awkyu/variable-force-servo-controller/Kyu_Alexander_Project_Report.pdf

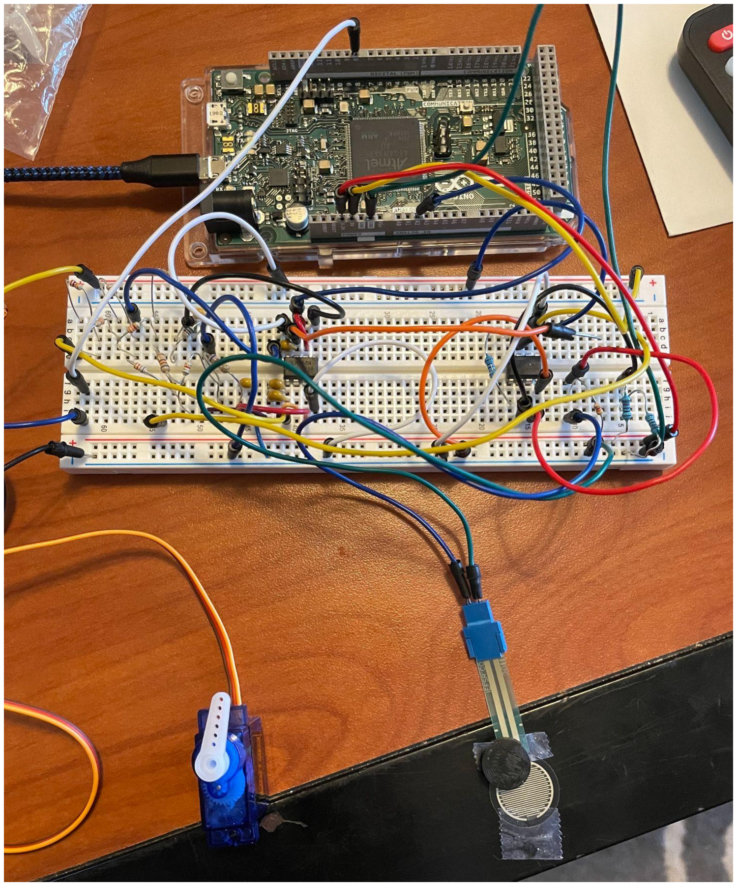
[picture p12: figure]
