awkyu/variable-force-servo-controller/IMG_8414.jpg

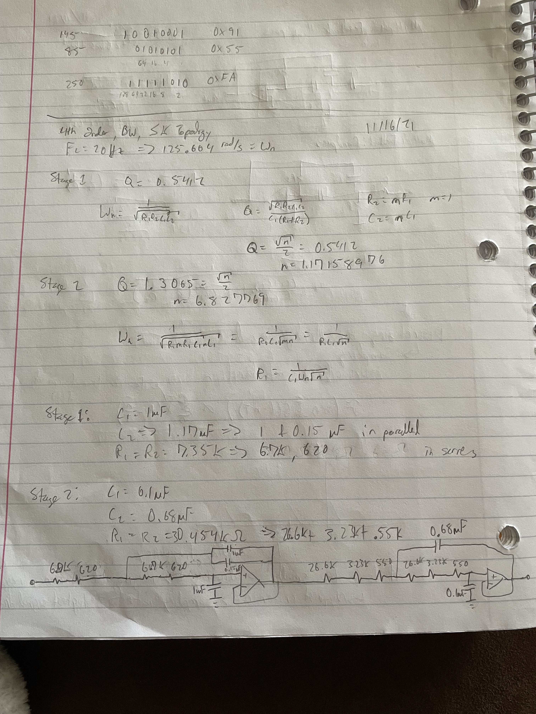
IMG_8414.jpg
