awkyu/variable-force-servo-controller/IMG_8416.jpg

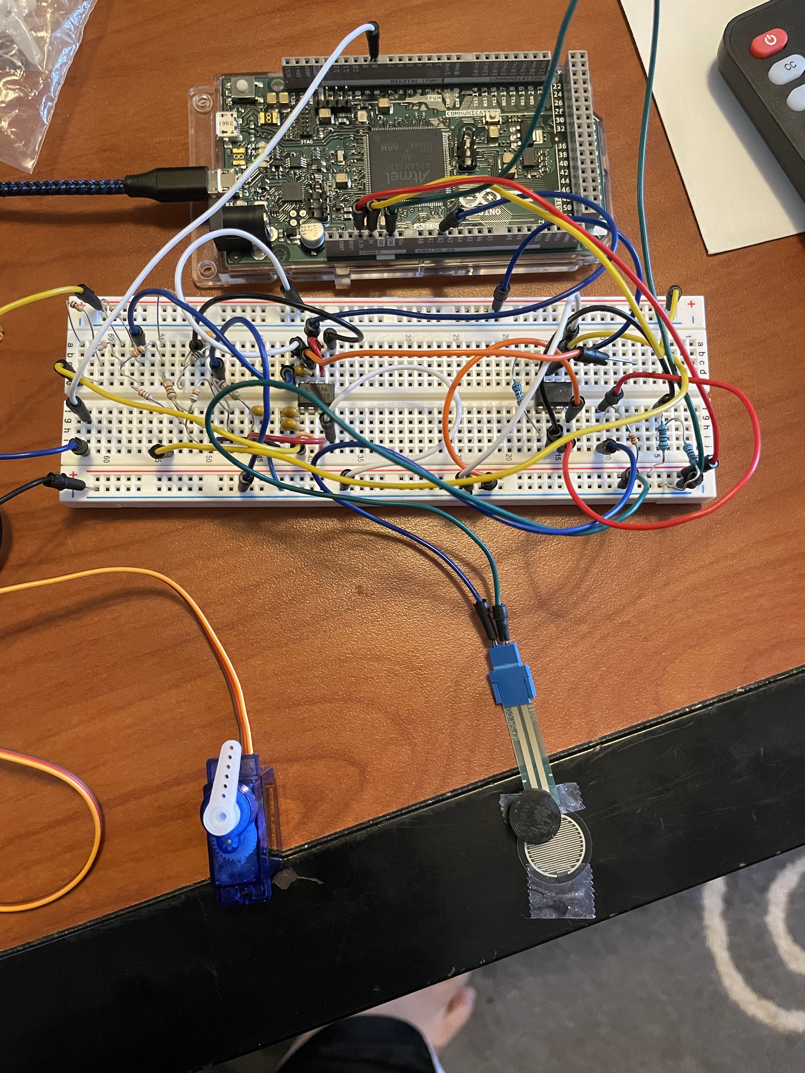
[picture p1: IMG_8416.jpg]
IMG_8416.jpg
